cobetckoe/HeartbeatSensor/README.md

# 坎川工业 · 心跳探测器 v1.0.0



N4 模组（ESP32-C3-MINI-1-N4）+ HLK-LD2450 24GHz 毫米波雷达 + ST7735 彩屏的
实时目标跟踪与可视化固件，配 STC8G1K08A 从机做 433 MHz 单向下行，可选接入涂鸦云。

屏幕上是半圆雷达图：扫描量程圈、目标光点、方位网格、底部防区状态条。
左上角是 WiFi/云状态徽标，**右上角是电池电量徽标**。
开机先显示一块 **坎川工业** LOGO（齿轮 + 坎卦 ☵），然后直接进入雷达界面。

```
       ╭──────────────╮          量程 6 m / ±95°
      ╱   ●              ╲       最多同时 3 个目标
     │       ●            │      声呐波纹式 ping 圆环向外扩散
     │  ────────────      │      底部 4 防区状态条
      ╲                    ╱
       ╰──────────────────╯
        ▓▓▓▓  ▓▓▓▓  ░░░░  ░░░░
```

---

## 文档

| 文档 | 内容 |
|---|---|
| 本文 | 硬件、接线、构建烧录、按键语义、雷达规格 |
| [docs/HARDWARE.md](docs/HARDWARE.md) | 硬件说明：引脚约定、不可省略的硬件约束、从机充电方式 |
| [docs/PROTOCOL-433M.md](docs/PROTOCOL-433M.md) | 433 MHz OOK 空中协议（编码、帧结构、CRC、节奏） |
| [docs/DISPLAY.md](docs/DISPLAY.md) | 屏幕渲染：SPI 初始化、推帧门控、配色、版面几何、开机 LOGO |
| [docs/DIAGNOSTICS.md](docs/DIAGNOSTICS.md) | 诊断手册：现象速查表 + 串口日志逐条判读 + 两个必须知道的坑 |
| [docs/TUYA-DP-SETUP.md](docs/TUYA-DP-SETUP.md) | 涂鸦 DP 建点、倍数填写、三元组、数据中心 |
| [CHANGELOG.md](CHANGELOG.md) | 版本历史 |

---

## 硬件

**硬件设计（原理图 / PCB / 3D / BOM）在立创开源硬件平台发布，本仓库不含硬件工程文件。**

| 部件 | 型号 |
|---|---|
| 主控 | **N4 模组**（ESP32-C3-MINI-1-N4） |
| 雷达 | **HLK-LD2450** 24 GHz FMCW |
| 屏幕 | **ST7735** 1.8" 160×128 |
| 无线 | **433 MHz OOK** 发射 / 接收模组 |
| 从机 | **STC8G1K08A** SOP8 + **RCWL-0515** |
| 供电 | 主机 / 从机各用 3.7 V 锂电；从机由**弹匣式一拖四充电座**统一充电 |

- **主机与从机之间没有有线连接**，只有 433 MHz 单向无线链路（从机发射 → 主机接收）。
- **从机自身不带充电电路**，只引出 2 片磁吸触点，放回弹匣座即充。

> 引脚约定与不可省略的硬件约束见 [docs/HARDWARE.md](docs/HARDWARE.md)；
> 原理图、PCB、BOM 与装配细节见立创开源硬件平台项目页。

---

## 快速开始

### 1. 装依赖

```powershell
pip install -r requirements.txt   # pyserial
pip install Pillow                # 只有改 LOGO 才需要
```

### 2. 构建

```powershell
.\utils\build.ps1                 # 增量构建
.\utils\build.ps1 -Clean          # fullclean 后重建
.\utils\build.ps1 -Monitor        # 构建完进串口
```

### 3. 烧录

```powershell
.\utils\flash.ps1                 # 自动找串口 → 编译 → 烧录
.\utils\flash.ps1 -Port COM30 -Monitor   # 指定串口，烧完看输出
.\utils\flash.ps1 -Raw            # 绕过 pio，用 esptool 手动烧
```

板子认不出来时：**按住 BOOT 再点一下 RESET**，让它进下载模式。

> **为什么脚本要自己挑 pio**：本机有两个 pio，其中
> `C:\.platformio\penv\Scripts\pio.exe` 缺 `intelhex`，链接阶段会报
> `ModuleNotFoundError: No module named 'intelhex'`。两个脚本都会优先选不在
> `penv` 下的那个，不用手动处理。
>
> `-Raw` 走 esptool 手动写 4 个分区（bootloader / partitions / boot_app0 /
> firmware），实测可用，`pio upload` 抽风时拿它兜底。

### 4. 看日志

```powershell
python utils\serial_monitor.py    # 自动重连，已抑制 DTR/RTS 复位
```

**遇问题第一件事就是接串口。** 现象速查与日志判读全部见
[docs/DIAGNOSTICS.md](docs/DIAGNOSTICS.md)。

---

## 工程结构

```
HeartbeatSensor/
├── src/
│   ├── master/                       ★ 主机固件（N4 模组 / ESP32-C3，PlatformIO）
│   │   ├── master.ino                主程序：初始化 + 主循环
│   │   ├── HLK_LD2450.h              雷达协议解析（header-only）
│   │   ├── RadarDisplay.h            雷达界面渲染（header-only）
│   │   ├── OokReceiver.h             433M OOK 接收 + 解帧
│   │   ├── ZoneManager.h             防区管理 / 配对 / NVS 持久化
│   │   ├── DebugLog.h                零堆分配日志 + 复位原因
│   │   ├── BatteryMonitor.h          电池电压采样 + 电量百分比换算
│   │   ├── LogoImage.h               LOGO 点阵，脚本生成，勿手改
│   │   ├── TuyaLink.h                涂鸦云 MQTT + WiFi 状态机 + AP 配网
│   │   ├── TuyaConfig.h              涂鸦/配网参数集中配置
│   │   ├── QrTextImage.h             二维码说明文字点阵，脚本生成，勿手改
│   │   └── platformio.ini
│   └── slave/                        ★ 从机固件（STC8G1K08A，Keil C51）
│       ├── source/                   源码（GBK 无 BOM）
│       │   ├── main.c                主程序：初始化 + 主循环
│       │   ├── app.c                 按键 / 状态机 / 发送调度
│       │   ├── ook433.c              433 OOK 发射驱动
│       │   ├── board.h               引脚定义
│       │   └── include/              app.h / config.h / def.h / ook433.h / STC8 头文件
│       └── slave.uvproj              Keil 工程（BOM-free）
├── docs/                             ★ 细节文档
│   ├── PROTOCOL-433M.md              433 MHz OOK 空中协议
│   ├── DISPLAY.md                    屏幕渲染 + 开机 LOGO
│   ├── DIAGNOSTICS.md                诊断手册
│   ├── HARDWARE.md                   硬件说明：BOM / 接线 / 引脚 / 天线
│   └── TUYA-DP-SETUP.md              涂鸦 DP 建点
├── utils/                            构建 / 烧录 / LOGO / 串口脚本
│   ├── fonts/                        第三方字体（不入 Git，请跑 fetch_seal_font.py 下载）
│   └── *.png                        LOGO / 预览图（不入 Git，由 make_logo.py 生成）
├── CHANGELOG.md
├── LICENSE                           MIT 官方全文
├── NOTICE                            版权 / 第三方组件 / 致谢
└── requirements.txt
```

**在维护的固件只有两个**：主机 `src/master/`（PlatformIO）、从机 `src/slave/`（Keil C51）。

### 从机固件

需要 Keil C51 V9.60+：

```powershell
.\utils\build_slave.ps1          # 增量编译
.\utils\build_slave.ps1 -Clean   # 清理后完整重建
```

产出 `src\slave\Objects\slave.hex`，用 **STC-ISP** 烧录。

> ⚠️ `slave.uvproj` **不能带 UTF-8 BOM**，否则 UV4 静默失败（`Exit=15`，
> 不写日志、不报错、无产物）。`build_slave.ps1` 已自动检测并剥离。
> 同理，`src\slave\source\**` 的 `.c` / `.h` **必须保持 GBK 无 BOM**，
> Keil C51 按 GBK 解释源码，转成 UTF-8 会让中文注释炸成语法错误。

### PlatformIO 工程

`platformio.ini` 里用 `src_dir = .` 把 sketch 目录本身当源码根：

```powershell
pio run -d .\src\master              # 构建
pio run -d .\src\master -t upload    # 烧录
```

**不要同时跑两个 `pio run`**，会互相破坏 `.pio\build`。

---

## 工具脚本

| 脚本 | 用途 |
|---|---|
| `build.ps1` | 构建主机固件 |
| `flash.ps1` | 烧录主机固件 |
| `build_slave.ps1` | 构建从机固件（Keil UV4） |
| `make_logo.py` | 生成内置几何 LOGO |
| `logo_converter.py` | 把 PNG 转成固件点阵 |
| `fetch_seal_font.py` | 下载小篆字体 |
| `make_qr_text.py` | 二维码说明文字 → `QrTextImage.h` |
| `serial_monitor.py` | 简易串口监视 |

### LOGO

```powershell
python utils/make_logo.py                              # → utils/logo_*.png
python utils/logo_converter.py utils\logo_160x128.png  # → 固件点阵
```

**用自己的图**：存成 `utils/logo.png`（也认 `.jpg` / `.jpeg` / `.bmp`）再跑
`logo_converter.py` 即可。`make_logo.py` 永远不会覆盖 `logo.png`。

篆书版需先跑 `python utils/fetch_seal_font.py` 下 21.8 MB 字体（不入 Git）。
篆书在 160×128 的屏上认不出来，只用于大幅面 / 印刷，见
[`utils/fonts/README.md`](utils/fonts/README.md)。

`logo_converter.py` 两个产物：

- `src/master/LogoImage.h` —— 固件编译时自动 `#include`
- `utils/logo_preview.png` —— **屏上实际效果**，烧之前先看它

设计理念与全部输出版本见 [docs/DISPLAY.md](docs/DISPLAY.md) 第二部分。

### 二维码说明文字

配网页上那段说明文字是点阵图（GFX 字模没有中文）：

```powershell
python utils\make_qr_text.py     # → src/master/QrTextImage.h + qr_text_preview.png
```

改文案就改脚本里的字符串，跑完先看 `utils/qr_text_preview.png` 再构建。
`QrTextImage.h` 是**脚本生成**的，不要手改。

---

## 工作原理

上电流程：

```mermaid
flowchart TD
    A[上电] --> B[点亮背光]
    B --> C["硬件 SPI 初始化<br/>显式指定 SCLK/MOSI"]
    C --> D["initR BLACKTAB<br/>setRotation 1"]
    D --> E["显示 LOGO 1.5 s"]
    E --> F{"NVS 里<br/>有配置吗"}
    F -->|有| G[按存的参数开串口]
    F -->|没有| H[扫描 RX/TX 与波特率]
    G --> I{"收到合法数据吗"}
    I -->|是| K[进入雷达界面]
    I -->|否| H
    H --> J[锁定参数写入 NVS]
    J --> K
    K --> L["主循环 ~50 Hz"]
```

只识别一种数据帧头：`AA FF 03 00`，说明是雷达的目标跟踪帧。

雷达的**串口引脚和波特率只在第一次上电时扫描一次**，之后锁在 NVS 里，往后开机
直接按存的参数开串口，不再浪费时间扫描。想重新扫描：擦除 flash 重新上电。

主循环只做三件事：读帧 → 过滤 → 画。过滤条件是距离 0.05–8 m、角度 ±95°，
滤掉的是雷达偶发的 0 距离和越界噪声。

---

## 显示实现

屏幕子系统有一定陷阱（SPI 初始化顺序、离屏画布、脏矩形、推帧门控、配色分级、
角度约定），**完整说明见 [docs/DISPLAY.md](docs/DISPLAY.md)**。

三件必须知道的事：

- 必须在 `initR()` 之前调 `SPI.begin(TFT_SCLK, -1, TFT_MOSI, -1)`，任何地方都
  不要再调无参 `SPI.begin()`（会把 SCLK 从 GPIO6 挪到 GPIO4，直接花屏）
- 脏矩形起始列必须为偶数，否则 RISC-V 非对齐访存 panic
- SPI 时钟固定 20 MHz：40 MHz 会干扰 433 MHz 接收

---

## 按键

### 主机 BOOT

| 操作 | 效果 |
|---|---|
| 短按 BOOT | 开 / 关屏幕 |
| 双击 BOOT | 进入配对模式 |
| 长按 2 s | 开 / 关 WiFi（涂鸦云接入） |
| 长按 5 s | 恢复出厂（清防区 + 清 WiFi + 清三元组） |

配对模式内：单击切防区 A→B→C→D，长按 1.5 s 对当前防区开始配对。

### 从机 P3.2

按键语义**按状态分离**，而且**全部动作都在松手那一拍完成，没有任何等待窗口**：

| 状态 | 操作 | 效果 |
|---|---|---|
| **待机** | 单击（30~1200 ms） | 开检测 |
| **待机** | 长按 1.5~5 s | 进配对（20 s 窗口） |
| **检测** | 单击或长按 | 关检测（松手**立即**生效，不设时长上限） |
| **配对** | 单击或长按 | 退出配对，回待机 |

> 长按阈值 1.5 s 与主机 `BTN_LONG_PAIR_MS` 一致，现场两只手同时按住即可。
> 单击上限 1.2 s 与长按下限 1.5 s 之间留了 300 ms 空档，手抖不会误进配对；
> 超过 5 s 视为按钮被压住，整次丢弃。

**为什么不需要「等 400 ms 看有没有第二下」**：早期三个状态都「松手即刻切换」，
代价是待机态「单击开检测」与「双击进配对的第一下」无法区分。
现在把配对改成**长按**，单击与长按在时间上天然分开，所有状态都可以
松手即时生效——「关检测」永远是秒回的，「开检测」也不再有 0.4 s 延迟。

**布防态必须看到一次真实的按下采样才允许关闭检测。**
纯粹由 INT0 下降沿触发、从未采到过低电平的事件（例如 433 发射突发或
继电器吸合造成的地弹毛刺）在布防态会被拒绝——否则会出现「刚开好的检测
被自己关掉」，那是漏报。代价是：按下和松开正好都落在 146 ms 发射块里时，
这一次按压不生效，再按一下即可。详见
[docs/DIAGNOSTICS.md](docs/DIAGNOSTICS.md) 的「开了之后很快自己又关了」。

**从机上电默认待机**：不采样、继电器释放、只发 10 秒一次的「无人」心跳。
必须单击一次才真正开始检测。

> 为什么：RCWL-0515 和主板装在同一个壳里，上电后雷达会把**从机自己**
> 当成目标，OUT 直接拉高。原来「上电即检测」= 每台从机一上电就报有人，
> 主机所有防区同时亮红。改成上电待机后，装柜/调试期间从机是安静的，
> 装好、人离开、再按一下按钮才算真正布防。

**配对的两个退出路径**：20 s 超时自动回待机，或配对期间单击一下提前退出。
从机没有 RX（433 对从机是纯单向 TX），**感知不到主机「配对成功」**，
所以不存在「配对成功即自动退出」；看到主机提示配对完成后再单击一下即可。

**退出后短暂静音**（`s_click_mute`，400 ms）：在检测态快速连按两下时，
第二下不会被当成「待机单击」把检测又打开——连按两下的结果就是关闭。

开启检测后还有 `APP_ARM_BLIND_MS`（500 ms）的雷达基线盲区，
这是留给人员撤离的时间，属于有意设计，不要改小。

待机期的 10 秒慢心跳让防区在屏上/APP 上保持**在线**（主机离线门限 45 s）。
若现场待机时防区偶尔闪一下离线（433 链路丢帧是成簇的），
把 `app.h` 里的 `APP_STANDBY_HB_MS` 改小到 `5000u`。

### 从机按键指示灯（P3.2，纯硬件）

SOP8 的 8 个脚已经全部占满（P5.4 继电器 / P5.5 433 发射 / P3.0 P3.1 ISP /
P3.2 按键 / P3.3 雷达），**没有第二个可用的 IO**。所以按键指示灯不占用
任何新引脚，直接**串在 P3.2 的按键回路上**：

```
VCC ── LED ── R(330Ω~1k) ── P3.2 ──[按键]── GND
```

原理：P3.2 是准双向口，平时锁存器 = 1、内部弱上拉导通，引脚被拉到 VCC，
LED 两端等电位 → 无电流 → 灯灭。按下按键把引脚拉到 GND，电流经 LED + R
灌入地 → 灯亮；同时单片机读到低电平，按键逻辑照常工作。

**效果：手指按住按钮灯就亮，松开就灭 —— 固件完全不参与，没有任何延时。**

| 电阻 | 电流 | 观感 |
|---|---|---|
| 330 Ω | ≈4 mA | 够亮，准双向口上拉承受得住 |
| 1 kΩ | ≈1.3 mA | 偏暗但省电，室内仍可见 |

> 低于 220 Ω 会超出准双向口的驱动能力：灯反而变暗，甚至引脚电平抬不到
> 能识别的高电平，按键会读不到。

P5.4 因此**保持纯继电器输出**，不再兼任指示灯，也不会再因为「提示闪烁」
把继电器带得咔哒响。

---

## 涂鸦云接入（可选功能）

默认关闭，离线优先。长按 BOOT 2 秒开 WiFi，再长按 2 秒关。

### 配网

1. 长按 BOOT 2 秒，设备开热点 `Kanchuan-HB-XXXX`（开放，无密码）
2. 手机连该热点，浏览器自动弹出配网页（或手动开 `192.168.4.1`）
3. 选路由、填密码，需要换设备时展开「涂鸦云三元组」填 DeviceID / DeviceSecret
4. 保存后设备自动重启并直连

三元组也可写死在 `TuyaConfig.h`（`TUYA_PRODUCT_ID` / `TUYA_DEVICE_ID` /
`TUYA_DEVICE_SECRET`），NVS 优先于宏。数据中心选「中国数据中心」，选错设备不上线。

### DP 与绑定

**7 个 DP**（4 个 bool + 3 个数值），全部只上报。DP 清单、建点步骤、倍数填写、
三元组与数据中心设置见 **[docs/TUYA-DP-SETUP.md](docs/TUYA-DP-SETUP.md)**。

> ⚠️ 数值型 DP 的「倍数」必须填 **`0`**。填 `1` 会被平台当成一位小数，
> APP 上数字小 10 倍。

> ⚠️ **平台上只建这 7 个点。** 早期固件多报了 4 个 `zone_*_online`，
> 而平台上根本没建这四个点 → 涂鸦云**静默丢弃**（`publish()` 仍返回成功，
> 日志一切正常，但云端永远收不到）。防区离线状态现在不再单独上报，
> 现场以屏幕底部的三态防区条为准。

涂鸦智能 App **扫码添加不适用**——本固件直连云 MQTT，不走 App 配网，
不产生绑定 token。要进 App 需走云开发 OpenAPI 绑定或自研 App。

---

## 雷达规格

| 项目 | 参数 |
|---|---|
| 探测距离 | 0–6 m（本工程） |
| 角度范围 | ±60°（本工程过滤到 ±95°） |
| 最大目标 | 3 个 |
| 协议 | UART，头部 `AA FF 03 00` |
| 刷新率 | ~10 Hz（模组侧） |
| 屏幕量程标注 | 圈上标 `2m` / `4m` / `6m` |

### 航迹跟踪（为什么显示是稳的）

传感器本身只有 3 个目标槽位，而且会随时重排。直接照抄它的输出会看到三种
「不准」，本工程在画之前加了一层航迹跟踪来消除：

| 现象 | 原因 | 处理 |
|---|---|---|
| 同一个人莫名其妙换颜色 | 颜色按传感器槽位取，槽位会重排 | 持久航迹池 + 最近邻关联，目标自己占住一个槽 |
| 光点持续小幅抖动 | 传感器 10 Hz、屏幕 50 Hz，同一采样重复画 5 帧 | EMA 平滑（系数 0.45） |
| 目标偶尔闪一下消失 | 传感器漏采一次（该槽 x=y=0） | 350 ms 短时保持 |
| 角度偏一点 | 原按 2° 栅格对齐后查表 | 2° 查表 + 线性插值，量化误差 ~0.02° |

精确数值以云端 DP 为准（`radar_distance` 1 cm / `radar_angle` 1°），
屏幕上只标量程圈 `2m` / `4m` / `6m` 和方位角刻度 `-60 / -30 / 30 / 60`，
不占额外版面。

---

## 改文档的规矩

1. **一个事实只写一处**，其他地方链接过去。同一参数在两个文档里写两个值，
   迟早会有一个是错的。
2. 所有 `.md` 存 **UTF-8 带 BOM**。PowerShell 5.1 的 `Out-File -Encoding UTF8`
   会带 BOM，但 `Set-Content` 不一定，写脚本时用
   `[System.IO.File]::WriteAllText($p, $s, (New-Object System.Text.UTF8Encoding($true)))`。
3. `src/slave/source/**` 的 `.c` / `.h` 必须保持 **GBK 无 BOM**（见上文）。
4. 贴代码时贴**真实格式串**，不要手打近似值——日志格式改了要同步改文档。

---

## 开源协议

[MIT License](LICENSE)

Copyright (C) 2026 Kanchuan Industrial。
第三方组件、派生作品与致谢的声明见 [NOTICE](NOTICE)。

## 致谢

- **Adafruit** — GFX / ST7735 驱动
- **eric-rolph/esp32-radar-tracker** — ESP32-S3 + HLK-LD2450 雷达跟踪器参考项目（Arduino / CircuitPython 双实现）：
  <https://github.com/eric-rolph/esp32-radar-tracker>
