cobetckoe/HeartbeatSensor/docs/SERIAL-LOG.md

# 串口日志与判读

115200 baud，**事件驱动**（不轮询、不刷屏）。正常静默运行，只有下面这些
时机才会有输出。日志全部走 `DebugLog.h` 的 `dbgLog()`：224 字节栈缓冲、
零堆分配、USB CDC 非阻塞发送（缓冲区满直接丢，绝不阻塞主循环）。

**排查任何问题的第一步都是接串口。** 本文按日志行分组，每条都给出真实格式串
（从 `src/master/master.ino` 直接复制）和判读方法。

---

## 1. 开机

```
=== HEARTBEAT v7 C3 ===
[BOOT] reset=%s raw=0x%02X(%s) heap=%lu
[ZONE] stored=%d
[ZONE]  #%d id=%s name=%s en=%d
[BOOT] loop WDT %s (5s)
[OK] %s
```

真实示例：

```
=== HEARTBEAT v7 C3 ===
[BOOT] reset=SW raw=0x03(SW) heap=265004
[ZONE] stored=1
[ZONE]  #0 id=F7:94:C6:19:19:CB:3D name=A en=1
[BOOT] loop WDT armed (5s)
[OK] RUNNING
```

### `[BOOT] reset=` —— 第一行就该看这个

现场说「死机了」之后重启，靠这一条就能把原因分到三类，**三者修法完全不同**：

| `reset=` | 含义 | 该查什么 |
|---|---|---|
| `SW` / `0x03` | 软件复位（`ESP.restart()`） | 正常：配网保存后、工厂复位后都会这样 |
| `BROWNOUT` / `0x0F` | **掉电复位** | 供电被拉垮。最常见：433 发射瞬间 Vcc 塌陷、USB 线太细、雷达 5V 与模块共用一路 |
| `TASK_WDT` / `0x0B` | **主看门狗** | 主循环被阻塞 5s 以上。查是否有新增的阻塞调用 |
| `PANIC` | 程序异常 | 看核心转储；常见是 `LoadStoreAlignment`（非对齐访存）或踩穿栈 |
| `0x15` | USB 串口（烧录后） | 正常：刚烧完就这行 |

### `[ZONE] stored=` —— 配不上对时的决定性证据

打印主机 EEPROM 里**已保存的**从机 ID。必须拿它和后面 `[OOK]` 行里从机
**实际发的** ID 逐字节对照：

- 一致 → 配对正常
- **不一致 → 主机根本不认这台从机**。换芯片 / 换整块板子后 STC8 的出厂
  唯一 ID 就变了，此时「防区永远离线、报警反复复位」，现场表现像「采样慢 /
  延时大 / 从机重启」，实际是没配对
- `stored=0` + `(empty - press PAIR on the slave)` → 从没配过对

> ⚠️ **只看到 `[OOK]` 行就以为收到了，是最容易踩的坑。** `[OOK]` 行是无条件
> 打印的（任何 ID 都打），而只有 ID 匹配才会更新防区。

### `[OK] RUNNING` / `[OK] NO DATA`

雷达 UART 是否在开机时探测到数据。`NO DATA` 不代表故障——本固件会把 UART
先起在 256000，之后传感器上电/复位还能接住，屏幕依然进雷达界面。
真正的判据是下面第 3 节的 `[RADAR]` 行。

---

## 2. 收帧事件

```
[OOK] %02X:...:%02X flags=%02X seq=%u
[OOK] Already-known device seen during pairing
```

`[OOK]` 只在**首次见到某台设备**时打印（靠 `static s_logId[7]` 去重），
不是每帧都刷。所以日志里有这一行 = 射频链路和协议解码都是通的。

`flags` 位含义：

| 位 | 含义 |
|---|---|
| `0x01` | `OOK_FLAG_PRESENCE` 检测到人 |
| `0x08` | `OOK_FLAG_PAIRREQ` 从机主动请求配对 |
| `0x80` | `OOK_FLAG_BOOT` 从机刚重启（开机后前几帧置位，正常运行永不置位） |

`0x02` / `0x04` 是协议保留位（防拆 / 低电），从机目前从不置位。

---

## 3. 每分钟健康日志（核心）

每 60 秒打印一组 7 行。**这是验证长期可靠性的唯一客观手段。**

```
[ZONE ] zn=%d act=%d
[ZONE ]  #%d id=%s name=%s en=%d on=%d f=%u age=%lums     ← 每个防区一行
[HEALTH] up=%lum heap=%lu min=%lu loop=%lums stk=%u tstk=%u ook=%lu crc=%lu nz=%lu ovf=%lu T=%uus rst=%u rbt=%lds wdt=%s did=%s
[GATE] fs=%lu fh=%lu
[RADAR] ok=%lu bad=%lu raw=%lu
[FAIL] f1=%u f2=%u f3=%u f4=%u f5=%u f6=%u f7=%u f8=%u f10=%u f11=%u
[FIXB] fixed=%lu wbit=%d wcnt=%u
```

### `[HEALTH]` —— 现场只需先看这三个数

| 字段 | 含义 | 正常值 |
|---|---|---|
| `heap` | 当前空闲堆 | ≥ 180000，且**不单调下跌** |
| `min` | 上电以来最低水位 | **等于 `heap` ⇒ 零泄漏**（稳态下两者应几乎相同） |
| `loop` | 主循环最坏耗时（本分钟） | 10–20 ms，必须远小于 5000（WDT） |
| `up` | 连续运行分钟数 | 递增；**变小说明重启过** |

其余字段：

| 字段 | 含义 | 判读 |
|---|---|---|
| `stk` | 主循环栈剩余（字节） | > 1500 安全；**< 500 立即加大** |
| `tstk` | tuya 任务栈剩余 | > 3000 安全；**< 500 改 `TUYA_TASK_STACK`** |
| `ook` | 累计有效帧 | 单调递增 |
| `crc` | 累计校验错 | 应长期接近 0（1% 以内属信道正常噪声） |
| `nz` | 噪声突发数 | **大而 `ook` 小** → 433 接收模块一直在自激，帧头立不起来，是射频问题，调固件无用；**小** → 接收机干净，问题在信号弱（功率/天线/距离）或从机发得不对 |
| `ovf` | RMT 环形缓冲溢出次数 | > 0 说明主机边沿都来不及读，**帧是主机丢的，与射频无关** |
| `T` | 单位时长估计（µs） | 设计值 350。明显偏离说明接收模块脉宽失真 |
| `rst` | 从机重启次数 | 见下表 |
| `rbt` | 距上次重启秒数 | `-1` = 从未观察到重启 |
| `wdt` | 看门狗状态 | 必须是 `armed`；`FAILED` 才是真故障 |
| `did` | 涂鸦 DeviceID | 未配网时为空 |

**`rst` / `rbt` 判读：**

| 现象 | 结论 |
|---|---|
| `rst` 不涨，`rbt` 很大或 `-1` | 从机运行正常，问题在射频 / 供电 |
| `rst` 持续上涨，`rbt` 很小 | **从机在反复重启**。最常见：433 发射瞬间把 Vcc 拉塌导致欠压复位 |
| `rst` 涨一次就停 | 只是上电启动，正常 |

> `rst` 用 `OOK_FLAG_BOOT` 做确定性判据，**不靠 seq 猜**。因为 seq 只有 8 位，
> 从机约 35~40 帧/分，6~7 分钟就回绕一次，「seq 变小」既可能是重启也可能是
> 回绕。判定窗口取 5s 会漏检（丢帧 85% 时相邻帧间隔常 > 5s），取 60s 又会把
> 正常回绕误报成重启——两个方案都实测被证伪过。

### `[ZONE ]` 行

| 字段 | 含义 |
|---|---|
| `zn` / `act` | 已配防区数 / 当前活动槽位 |
| `on` | 是否在线 |
| `f` | **该防区最近 60 秒收到多少有效帧** |
| `age` | 当前帧龄（距最近一帧成功解码多久） |

`f` 是「多防区链路质量」的唯一硬指标。**心跳已从 3000 ms 改成 2000 ms，
判读基准必须跟着改**，否则现场会把正常误判成丢帧：

| `f` | 结论 |
|---|---|
| 45~60 | 链路正常（设计值 2000 ms/次 × 2 帧 = 60 帧/分） |
| 15~30 | 丢帧明显（天线 / 距离 / 供电 / 相位碰撞） |
| 0 | 该防区链路已断（或从未配对），看 `nz` / `age` 区分是射频问题还是 ID 不匹配 |

四个防区的 `f` **相差很大** = 典型的相位碰撞或某台天线差；
**四个都低** = 主机侧问题（接收模块 / 干扰 / 推屏门控）。

> ⚠️ **防区槽位必须逐个打印。** 这是踩过的真实误判：实际数据在 3 号槽
> （0/1/2 是空槽），而诊断只取了 `zoneAgeMs(0)` —— 空槽 `lastSeenMs` 恒为 0，
> 于是 `age` 天生等于开机时长，看起来像「从来没配对成功」，据此得出的
> 「ID 不匹配」结论完全是假的。多槽结构一律全打印，不要假设 0 号槽。

### `[GATE]` —— 联网后才需要看

`fs` = 软强制放行次数，`fh` = 硬强制放行次数（本分钟）。

| 数值 | 含义 |
|---|---|
| `fs=0 fh=0` | 门控从来没卡住过（WiFi 关或干扰很轻），画面一直流畅 |
| `fs` 有小量、`fh=0` | 只是安静窗偶尔不满足，柔性强制已够，正常 |
| **`fh` 持续增长** | 433 接收模块被 2.4 GHz 压得**持续自激**——屏幕靠硬强制保活，属射频/摆位问题（挪远天线、加电源去耦），调固件无用 |

机制说明见 [DISPLAY.md](DISPLAY.md) 第 3 节「分级强制放行」。

### `[RADAR]` —— 「雷达不出数」的第一个分叉点

| 字段 | 含义 |
|---|---|
| `raw` | UART1 累计收到的**字节数** |
| `ok` | 校验通过并解析成功的完整帧数 |
| `bad` | 帧头对上但帧尾不对的帧数 |

| 现象 | 结论 |
|---|---|
| `raw` 一直不涨 | **物理层没通**：TX/RX 接反、传感器没供电、传感器还在启动（LD2450 上电约 1 s） |
| `raw` 在涨、`ok` 不涨 | 波特率不对（本工程按 256000 探测）或帧被截断 |
| `bad` 明显增长 | 线路噪声，或波特率擦边（帧头对上、帧尾不对） |
| `ok` 在涨但屏幕上没点 | **已进入算法层**：看防区 / 跟踪门限，与 UART 无关 |

### `[FAIL]` —— 丢帧到底丢在哪道闸门

解码器每道闸门失败时用 `_fail(code)` 记一次，每分钟打一张直方图。
**一次 60 秒就能给出确定答案，不必再猜：**

| 占比最高 | 根因 | 对策 |
|---|---|---|
| **F11** | 位判错了（段长都在合法窗口内，只是长短判反）。根因是接收机 AGC 在某几个位上把边沿拉偏 ~250 µs | 调 `OOK_BIT_MIN/MAX` **无用**（本来就没越界）。看 `[FIXB]` |
| F2 / F3 / F7 / F8 | 有段长越界 → 这才是窗口问题 | 扩 `OOK_BIT_MIN` / `OOK_BIT_MAX` |
| F5 | 两簇分不开 → 该帧形状整体坏 | 通常是干扰 / 推屏致盲 |
| F1 / F6 | 载荷段数不够 → 帧尾被帧间隔吞掉的比例变了 | 查帧间隙 / 从机发送节奏 |
| F4 | 有效样本太少 → 帧体大面积丢失 | 查射频 |
| F10 | 出现等长段 → 极可能是噪声凑出来的假帧 | 查 `nz` |

### `[FIXB]` —— 单比特纠错成效

| 字段 | 含义 |
|---|---|
| `fixed` | 靠单比特纠错救回的帧数（说明纠错真在起作用，通信可靠性已实质提升） |
| `wbit` | 出错最集中的比特位 |
| `wcnt` | 该位出错的次数 |

若 `wbit` **长期固定在某一位**（尤其 79 号末位），说明该位的判定方法有
系统偏差（末位缺少配对段，只能靠全帧中点门限），应针对该位单独优化，
而不要整体调门限。

---

## 4. 事件类日志（低频，始终保留）

配对、工厂复位、按键等事件随时打印，不占用 60 秒节拍。

---

## 5. 两个必须知道的坑

**串口日志里不会出现任何 `[E]` 行。** `platformio.ini` 的
`-DCORE_DEBUG_LEVEL=0` 使 Arduino HAL 的 `log_e` / `log_w` / `log_i`
全部编译为空语句，所以像 `spiAttachMISO()` 那类无害但看着像故障的提示不会出现。
**若日志里真的冒出 `[E]`，那就是真故障，可以直接当报警看。**

**ESP32-C3 用原生 USB，打开串口这个动作本身会让芯片复位**（DTR/RTS）。
想测真实连续运行时间，请用 `utils/serial_monitor.py`（已做 DTR/RTS 抑制
+ 自动重连），不要用串口助手直接点开。
