cobetckoe/HeartbeatSensor/CHANGELOG.md

# 版本历史

## [未发布]

### 许可

- 开源协议由 **GPL-3.0-only** 回退为 **MIT**，采用最简单的单一许可结构。
  MIT 允许将 MIT 派生作品并入本工程，无需维护混合许可声明。
- `LICENSE` 改为 **MIT 官方全文**（不加任何附加段落），
  GitHub 可自动识别为 MIT。
- `NOTICE` 重写为 MIT 归属结构：项目版权抬头 → 派生作品
  （eric-rolph/esp32-radar-tracker，保留原 MIT 许可与版权全文）→ 第三方组件
  （Adafruit MIT/BSD、海凌科 HLK-LD2450、Keil C51 工具链）→ 致谢 → 联系方式。
- 全部源码的 SPDX 标识由 `GPL-3.0-only` 改回 `MIT`
  （主控 11 个文件 + 从机 7 个文件 + 2 个自动生成头文件）。
- 自动生成脚本 `utils/logo_converter.py`、`utils/make_qr_text.py` 同步改回 MIT。
- README 顶部 badge 改为 MIT，末章「开源协议」改为 MIT 链接与版权行。

### 命名

- 中文名称统一为 **心跳探测器**（原「毫米波雷达跟踪器」）。
  涉及 README 标题、`docs/HARDWARE.md` 标题、`src/master/master.ino` 文件头、
  `utils/build.ps1` / `utils/flash.ps1` 脚本说明。
  英文仓库名与目录名保持 `HeartbeatSensor` 不变。
  上游参考项目 `eric-rolph/esp32-radar-tracker` 的引用文字不改。

### 硬件

- **硬件设计（原理图 / PCB / 3D / BOM）改在立创开源硬件平台发布**，
  本仓库不含任何硬件工程文件。
- `docs/HARDWARE.md` 精简为「只提及」：从 15 245 字节降到 5 862 字节，
  只保留**固件强耦合的引脚约定**与**不可省略的硬件约束**两张表，
  其余（接线总表、物料清单、装配自检、充电座结构）全部指向立创项目页。
- 从机充电方式说明（只提及，不展开）：
  - **从机自身不带充电电路**，只引出 **2 片磁吸触点**，电池正极串 PTC 0.75 A。
  - **充电座即弹匣本体，一拖四**，插进去即充；磁极防呆，反了吸不住。

### 文档

- README 硬件章节改为**只提及**：删除接线总表、电池分压电路、从机接线、
  strapping 说明、引脚占用表、装配自检速查表、「供电与充电」小节，
  只留 6 行器件表 + 两句要点 + 指向立创项目页与
  `docs/HARDWARE.md` 的链接。
- README 由 477 行精简到 **444 行**。

### 致谢

- 收录参考项目 **eric-rolph/esp32-radar-tracker**（MIT）：
  <https://github.com/eric-rolph/esp32-radar-tracker>
- README「致谢」与 `NOTICE`「Acknowledgments」同步加入该项目。
- `src/master/HLK_LD2450.h` 基于该项目 `arduino/HLK_LD2450.h` 修改而来，
  `NOTICE` 中增加其 MIT 许可与版权声明，文件头保留原始归属。

## [1.0.0] - 2026-11-04

首次发布。

### 新增：电池电压监测与电量徽标

- `src/master/BatteryMonitor.h`（新增）：GPIO0 / ADC1_CH0，12 dB 衰减，
  `analogReadMilliVolts()` 走 eFuse 出厂校准，10 s 采样一次，13 点放电曲线查表换百分比
- 硬件：VBAT 经 1MΩ/1MΩ 分压，**中点必须并 100 nF**（源阻抗 500 kΩ，
  否则 SAR ADC 读数偏低）；分压常驻耗电 2.1 µA，约 1.8 %/yr
- 屏幕右上角电量徽标：外壳 17×9 @ (138,2)，正极尾巴 2×4，擦除区 (137,1)-(157,11)
  - ≥50% 绿 / 20~49% 琥珀 / <20% 红 / <5% 红且 1 Hz 闪烁
  - 未知（未采到电压）时**整块不画**，不误报 0%
- 电压越界（<1.5 V 或 >4.5 V）按 0% 显示，便于现场一眼识别接线错误

### 修复：涂鸦 DP 收敛为 7 个

- **删掉 4 个 `zone_*_online` DP**。平台上根本没建这四个点 → 涂鸦云**静默丢弃**
  （`publish()` 仍返回成功，日志一切正常，但云端永远收不到）—— 最难查的失败模式。
- 现在只上报平台上真实存在的 7 个点：101 距离 / 102 角度 / 103 目标数 /
  104~107 四个防区 presence
- MQTT 缓冲 1024 → 512 字节（7 个 DP 完整上报约 350 B）
- 防区离线状态不再单独上报，现场以屏幕底部三态防区条为准

### 修复：从机上电自动开检测（P3.2 浮空毛刺）

- `App_Init()` 在 `EA = 1` **之前**补 `IE0 = 0`。
  8051 的 `TCON.IE0` 是硬件边沿锁存，**与 `EX0` 无关** —— 上电爬升期间
  P3.2 上的任何下降沿都会被锁存，`EA` 一开就立刻进 ISR，
  待机态的边沿补救路径把浮空/毛刺当成一次按压 → 直接自动开检测。
- 电气结论：准双向口 P3.2 在 latch=1 时约 30 kΩ 内部弱上拉，
  悬空读数是稳定高电平（未按下），不存在阈值抖动 —— **IE0 锁存是唯一真实风险**。

### 文档

- `docs/TUYA-DP-SETUP.md` — 重写为 7 个 DP，补充 scale 语义、step=2 说明、
  以及「平台未建点会被静默丢弃」的来龙去脉
- `docs/DISPLAY.md` — 新增「顶部徽标区」章节：电池徽标几何、颜色分档、数据来源
- `README.md` — 引脚表、strapping 策略、电池接法、7 个 DP

### 资源占用

| 项目 | 数值 |
|---|---|
| 主机 RAM | 14.6 %（47820 / 327680 B） |
| 主机 Flash | 78.8 %（1032480 / 1310720 B） |
| 从机 `data` | 11.0 B |
| 从机 `xdata` | 58 B |
| 从机 `code` | 2479 B |
| 从机 hex | 7415 B（上限 8185 B，余量约 770 B） |
| 从机编译 | 0 Error / 0 Warning |

### 系统构成

- **主机**：N4 模组（ESP32-C3-MINI-1-N4）+ HLK-LD2450 24 GHz 毫米波雷达 + ST7735 1.8" 160×128 彩屏
- **从机**：STC8G1K08A SOP8 + RCWL-0515 微波感应 + 433 MHz OOK 发射模组
- **链路**：433 MHz OOK 单向下行（从机 → 主机），1 主机对最多 4 从机（防区 A/B/C/D）
- **云**：涂鸦云 MQTT 可选接入，默认关闭、离线优先

### 雷达与显示

- 半圆雷达界面：量程 6 m，方位 ±95°，最多同时跟踪 3 个目标
- 声呐波纹式 ping 圆环、2/4/6 m 量程圈、方位网格、底部 4 防区状态条
- 硬件 SPI 20 MHz（40 MHz 会干扰 433 MHz 接收）、`GFXcanvas16` 离屏合成、脏矩形增量推送
- 三级强制放行门控：正常等待 → 120 ms 软强制（1200 px）→ 400 ms 硬强制（600 px，帧内也强制），
  推屏预算自适应负反馈（正常 +20/帧、硬强制 −300，钳在 1500~3000）
- 背景静态部分开机预烘焙，每帧 `memcpy` 复用
- 开机显示坎川工业 LOGO 1.5 s（齿轮 + 坎卦 ☵，亮金 `#FFD800` + 正红 `#E60012`）

### 航迹跟踪

- 持久航迹池 + 最近邻关联，解决传感器槽位重排导致的目标换色
- EMA 平滑（系数 0.45）消除 10 Hz 传感器与 50 Hz 屏幕之间的重复帧抖动
- 350 ms 短时保持，遮盖传感器单次漏采
- 2° 查表 + 线性插值，量化误差约 0.02°

### 433 MHz OOK 协议

- PT2262 / EV1527 脉宽编码，`T = 350 µs`，码率 714 bps，与 rc-switch protocol 1 兼容
- 前导码 20 个 2T 脉冲 + 同步头（1T 高 / 16T 低）+ 10 字节载荷（ID7 / FLAGS1 / SEQ1 / CRC1）
- CRC-8/ATM（多项式 `0x07`，初值 `0x00`，无反射，无异或输出）
- 帧空中时间 145.95 ms（417T），协议 202 段、主机可捕获 201 段
- 主机侧 RMT 硬件解码（1 MHz tick），CPU 零参与；12 ms 空闲判帧
- 从机侧 `OOK_SendFrame()` 关中断阻塞发射，INT0 硬件仍锁存 `IE0`，`EA` 恢复后补处理

### 从机行为

- **上电默认待机**：不采样、继电器释放，避免上电时雷达把从机自身当目标导致全防区误报
- 待机期 10 s 慢心跳（2 帧），维持主机侧 45 s 离线门限内的「在线 + 无人」
- 状态变化立即发 3 帧；布防态心跳 2 s 一次
- 发送抖动 `gap_ms = 20 + (ID[0] % 40)`，多从机自然错开；最坏响应延迟约 556 ms
- 按键语义按状态分离，**全部动作在松手那一拍完成**：
  待机单击（30~1200 ms）开检测、待机长按（1.5~5 s）进配对、
  检测态单击或长按关检测、配对态单击或长按退出配对
- 布防态必须采到一次真实按下电平才允许关闭检测，拒绝 433 发射突发 / 地弹毛刺造成的假边沿
- 配对 20 s 窗口，两条退出路径（超时 / 按键），退出后 `s_click_mute` 400 ms 静音
- 从机无接收通路，无法感知「配对成功」，故不存在配对成功自动退出
- 按键指示灯纯硬件串在 P3.2 回路，零 IO 占用、零固件参与

### 主机按键

- 短按 BOOT 开关屏幕，双击进配对，长按 2 s 开关 WiFi，长按 5 s 恢复出厂

### 诊断

- `dbgLog()`：224 字节栈缓冲、零堆分配、USB CDC 非阻塞，115200 baud 事件驱动
- 每分钟健康日志：`[HEALTH]` / `[ZONE ]` / `[GATE]` / `[RADAR]` / `[FAIL]` / `[FIXB]`
- 复位原因与从机重启标记（`BOOT` 标志位）写入日志，仅用于诊断不参与报警判断
- 编译期 `-DCORE_DEBUG_LEVEL=0` 压制 Arduino HAL 的 SPI MISO 提示，成品日志无 `[E]` 行

### 工具链

- `utils/build.ps1` / `utils/flash.ps1`：主机固件构建与烧录，自动避开缺 `intelhex` 的 pio
- `utils/build_slave.ps1`：从机 Keil UV4 构建，自动剥离 `slave.uvproj` 的 UTF-8 BOM
- `utils/make_logo.py` / `logo_converter.py` / `fetch_seal_font.py`：LOGO 生成与点阵转换
- `utils/make_qr_text.py`：配网页说明文字点阵生成
- `utils/serial_monitor.py`：抑制 DTR/RTS 复位的简易串口监视

### 文档

- `README.md` — 硬件、接线、构建烧录、按键语义、雷达规格
- `docs/PROTOCOL-433M.md` — OOK 空中协议
- `docs/DISPLAY.md` — 屏幕渲染与开机 LOGO
- `docs/DIAGNOSTICS.md` — 现象速查 + 日志判读
- `docs/TUYA-DP-SETUP.md` — 涂鸦 DP 建点
