cobetckoe/HeartbeatSensor/src/slave/source/main.c

//<<AICUBE_USER_HEADER_REMARK_BEGIN>>
////////////////////////////////////////
// 文件名称: main.c
// 文件描述: 从机主程序 - STC8G1K08A + 433M OOK 发射
////////////////////////////////////////
// Copyright (C) 2026 Kanchuan Industrial
// SPDX-License-Identifier: MIT
//<<AICUBE_USER_HEADER_REMARK_END>>


#include "config.h"                     //默认已包含stdio.h、intrins.h等头文件


//<<AICUBE_USER_INCLUDE_BEGIN>>
// 在此添加用户头文件包含  
#include "board.h"
#include "ook433.h"
#include "app.h"
//<<AICUBE_USER_INCLUDE_END>>


//<<AICUBE_USER_GLOBAL_DEFINE_BEGIN>>
// 在此添加用户全局变量定义、用户宏定义以及函数声明  
//<<AICUBE_USER_GLOBAL_DEFINE_END>>




////////////////////////////////////////
// 项目主函数
// 入口参数: 无
// 函数返回: 无
////////////////////////////////////////
void main(void)
{
    //<<AICUBE_USER_MAIN_INITIAL_BEGIN>>
    // 在此添加用户主函数初始化代码  
    //<<AICUBE_USER_MAIN_INITIAL_END>>

    SYS_Init();

    //<<AICUBE_USER_MAIN_CODE_BEGIN>>
    // 在此添加主函数中运行一次的用户代码  
    App_Init();
    //<<AICUBE_USER_MAIN_CODE_END>>

    while (1)
    {
        //<<AICUBE_USER_MAIN_LOOP_BEGIN>>
        // 在此添加主函数中用户主循环代码  
        App_Run();
        //<<AICUBE_USER_MAIN_LOOP_END>>
    }
}

////////////////////////////////////////
// 系统初始化函数
// 入口参数: 无
// 函数返回: 无
////////////////////////////////////////
void SYS_Init(void)
{
    EnableAccessXFR();                  //使能访问扩展XFR
    IAP_SetTimeBase();                  //设置IAP等待参数,产生1us时基

    //<<AICUBE_USER_PREINITIAL_CODE_BEGIN>>
    // 在此添加用户预初始化代码  
    //<<AICUBE_USER_PREINITIAL_CODE_END>>


    //<<AICUBE_USER_INITIAL_CODE_BEGIN>>
    // 在此添加用户初始化代码  
    //<<AICUBE_USER_INITIAL_CODE_END>>
}

////////////////////////////////////////
// 微秒延时函数
// 入口参数: us (设置延时的微秒值)
// 函数返回: 无
////////////////////////////////////////
void delay_us(uint16_t us)
{
    do
    {
        NOP(14);                        //(MAIN_Fosc + 500000) / 1000000 - 10
    } while (--us);
}


////////////////////////////////////////
// 毫秒延时函数
// 入口参数: ms (设置延时的毫秒值)
// 函数返回: 无
////////////////////////////////////////
void delay_ms(uint16_t ms)
{
    uint16_t i;

    do
    {
        i = MAIN_Fosc / 10000;
        while (--i);
    } while (--ms);
}



//<<AICUBE_USER_FUNCTION_IMPLEMENT_BEGIN>>
// 在此添加用户函数实现代码  
//<<AICUBE_USER_FUNCTION_IMPLEMENT_END>>
