cobetckoe/HeartbeatSensor/src/master/QrTextImage.h

// QrTextImage.h - 由 utils/make_qr_text.py 自动生成，请勿手工编辑
// 中文提示点阵（1bit 掩膜，颜色在绘制时指定）
//
// Copyright (C) 2026 Kanchuan Industrial
// SPDX-License-Identifier: MIT
#ifndef QR_TEXT_IMAGE_H
#define QR_TEXT_IMAGE_H

#include <Arduino.h>

// HINT1  系统相机  48x12
#define QRT_HINT1_W 48
#define QRT_HINT1_H 12
static const uint8_t QRT_HINT1[72] = {
  0x00, 0xC0, 0x10, 0x10, 0x00, 0x00, 0x3F, 0x02, 0x10, 0x13, 0xE2, 0x38, 0x04, 0x02, 0x7E, 0x32,
  0x23, 0x2C, 0x19, 0x85, 0x90, 0x7E, 0x27, 0xA4, 0x1E, 0x07, 0x24, 0x33, 0xE2, 0x2C, 0x0C, 0xC2,
  0x66, 0x32, 0x23, 0x2C, 0x3B, 0xE2, 0x7A, 0x3E, 0x27, 0xAC, 0x02, 0x27, 0x28, 0x73, 0xE6, 0x2C,
  0x12, 0x80, 0x28, 0x52, 0x22, 0x6C, 0x22, 0x63, 0xA8, 0x12, 0x22, 0x48, 0x46, 0x24, 0x4E, 0x13,
  0xE2, 0xC6, 0x04, 0x00, 0x04, 0x00, 0x00, 0x00,
};

// HINT2  扫码入网  48x11
#define QRT_HINT2_W 48
#define QRT_HINT2_H 11
static const uint8_t QRT_HINT2[66] = {
  0x10, 0x00, 0x20, 0x08, 0x03, 0xFC, 0x13, 0xE7, 0x84, 0x0C, 0x04, 0x06, 0x78, 0x22, 0x04, 0x04,
  0x04, 0x02, 0x10, 0x22, 0x24, 0x06, 0x06, 0x6A, 0x11, 0x23, 0xA4, 0x06, 0x05, 0xB2, 0x18, 0x26,
  0xBE, 0x0D, 0x04, 0x92, 0x70, 0x26, 0x82, 0x09, 0x05, 0x92, 0x10, 0x22, 0xBE, 0x10, 0x85, 0x6A,
  0x10, 0x23, 0x82, 0x30, 0xC6, 0x62, 0x13, 0xE2, 0x02, 0x60, 0x64, 0x06, 0x20, 0x20, 0x04, 0x00,
  0x04, 0x04,
};

// HINT3  勿用微信  48x11
#define QRT_HINT3_W 48
#define QRT_HINT3_H 11
static const uint8_t QRT_HINT3[66] = {
  0x10, 0x01, 0xFC, 0x24, 0x81, 0x10, 0x10, 0x03, 0x22, 0x64, 0x83, 0x10, 0x3F, 0xE2, 0x22, 0x5E,
  0xE2, 0x00, 0x25, 0x23, 0xFE, 0x2F, 0xA6, 0x44, 0x49, 0x22, 0x22, 0x61, 0x06, 0x00, 0x09, 0x23,
  0x22, 0x61, 0x82, 0x7C, 0x32, 0x23, 0xFE, 0x2C, 0xC2, 0x00, 0x22, 0x62, 0x22, 0x2A, 0xC2, 0x46,
  0x04, 0x42, 0x22, 0x2A, 0xC2, 0x42, 0x18, 0x42, 0x26, 0x33, 0xE2, 0x7E, 0x10, 0xC0, 0x04, 0x23,
  0x22, 0x40,
};

#define QR_TEXT_IMAGE_AVAILABLE 1

#endif
