cobetckoe/HeartbeatSensor/(commit log)

2026-10-10 chore: 建立稳定基线 (v6 可运行版本)
    已实测通过的功能状态:
    - ESP32-C3 SuperMini + ST7735 160x128 (rot 1) 硬件 SPI @20MHz
    - HLK-LD2450 雷达 UART1 (GPIO4 RX / GPIO5 TX) @256000, 自动探测并锁定 NVS
    - 开机 LOGO 后直接进入雷达界面, 无任何中间检测页
    - 亮金 #FFD800 + 正红 #E60012 配色, 纯黑底最高对比
    - 全帧单窗口推送 pushCanvas(), 无花屏, 约 44 fps
    验证记录:
    - pio run: RAM 4.6% (15236 B) / Flash 26.8% (350926 B) / SUCCESS
    - esptool COM30 @460800: 4 段写入全部 Hash 校验通过
2026-10-10 chore: 按通用工程习惯整理项目结构
    在不改变固件行为的前提下，把仓库整理成「一个可维护工程 + 一份历史归档」的形态。
    清理后重新编译验证通过：RAM 4.6% (15236 B) / Flash 26.8% (350926 B)，与整理前一致。
    移除（内容已在 docs/legacy-snapshots/ 与 Git 历史中保留）
    - src/、include/：v9 双板（S3+C3）合并方案，已被 arduino/ESP32_C3_Radar_Tracker 取代
    - circuitpython/：早期 CircuitPython 原型，与当前 Arduino 固件无关
    - arduino/ESP32_Radar_Tracker/：ESP32-S3 分支，硬件已不再使用
    - 根 platformio.ini：旧的多 env 配置，指向已删除的 esp32s3
    - .vscode/launch.json：调试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
2026-10-22 feat: 画面流畅与 315MHz 收帧共存 (v7.2-display) + 工程结构整理
    一、推屏系统重做（核心修复）
    根因不是「推屏太久」，而是「单次连续 SPI 太久会被 RMT 录成一个假段」：
    帧长 163ms / 225 边沿，整屏推 21ms 阻塞会让接收机致盲，录出 ~10ms 平段，
    被判为一个超长段 → 整帧作废。决定成败的是单次连续 SPI 时长。
    三条规则：
    - SPI 固定 20MHz（40MHz 会把瞬态耦合进 315MHz DATA，crc>0）
    - 脏矩形 3000px 预算（≈6KB ≈2.4ms）；超预算本帧不推且不更新 _prev，
    差异累积到下一帧；有限预算模式下禁止整屏推
    - 门控 = !inFrame() && runSegs()==0 && push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
    [DebugLog.h, HLK_LD2450.h, LogoImage.h, OokReceiver.h, RadarDisplay.h, ZoneManager.h, app.c]
2026-10-22 fix: 光环卡死回退修复 + P3.3 检测脚失效安全加固 (v7.2.1-hotfix)
    ## 修复 1: 光环推到 1/3 处卡�? 随后整屏永久冻结
    pushDirty() 的推屏预算记错了量纲, 并叠加了一个死�?
    预算累加的是「逐行跨度之和」而不是实际脏像素:
    dirtyPx += (uint32_t)(hi - lo + 1);
    一条半�?r 的细圆弧跨很多行, 跨度之和约等�?pi*r^2. 代入预算 3000
    �?r ~= 31, 而雷达满量程半径�?96 -- 恰好在三分之一处越�? 这就�?
    肉眼看到的「推到一半�?
    越界后直�?return 且不更新 _prev, 本意是「差异累�? 等预算放开一次�?
    推出�? �?setPushBudget(3000UL) 每帧都在调用, 预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
    [RadarDisplay.h, app.c]
2026-10-28 feat: 涂鸦云接入 (TuyaLink MQTT) + 二维码配网
    新增 TuyaLink 云模块（离线优先，WiFi 开机默认关闭，长按 BOOT 2s 开启）：
    - ST_OFF/ST_SCAN/ST_WIFI/ST_TIME/ST_MQTT/ST_ONLINE + ST_AP 状态机，
    跑在独立 FreeRTOS 任务（栈 16384，prio 1）
    - HMAC-SHA256 鉴权，TLS 8883 连 m1.tuyacn.com，仅上报 11 个 DP
    - 三元组改为运行期 NVS 变量，配网页可填，不必重新编译
    - 雷达上报带死区（0.3m/5deg）+ 2s 节流
    AP 热点配网 + 屏幕二维码：
    - 无凭据或找不到路由时开热点 Kanchuan-HB-XXXX，captive portal
    - AP 模式屏幕显示 WiFi 二维码（微信/相机直扫免输密码）
    - 说明文字改为离线预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
2026-10-29 docs: 精简全部文档，去除过程叙述与注意事项
    - 重写 docs/TUYA-DP-SETUP.md，修复 GBK 转码造成的乱码
    - README 精简显示实现要点、常见问题、涂鸦章节
    - PROTOCOL-315M 精简编码原理与陷阱叙述
    - CHANGELOG v7.3 章节改为变更条目
    - legacy-snapshots README 精简
2026-10-29 feat: 雷达角度刻度 + DP 倍数修正(0) + 距离改厘米 + 无线方案统一 433 MHz
    - DP 倍数改 0（平台 scale 语义是小数位数，填 1 会让 APP 数值小 10 倍）
    - radar_distance 单位 0.1m -> cm，固件发整数厘米；DIST_EPS 3->30（等价 0.3m）
    - RadarDisplay: 网格标注 -60/-30/30/60 度（度符号 drawCircle 手画，GFX 无该字形）
    - 删除左上角数值读数与 0 度标注；量程圈补 2m/4m/6m（6m 原坐标越界）
    - 命名统一 315->433: ook433.h/.c、PROTOCOL-433M.md、PIN_TX433、__OOK433_H__
    - 天线 λ/4 23.8cm -> 17.3cm；协议与载波无关，解码逻辑零改动
    - 从机 GBK 文件按 GBK 读写，中文零损；slave.uvproj 保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
    [DebugLog.h, OokReceiver.h, RadarDisplay.h, TuyaConfig.h, TuyaLink.h, ZoneManager.h, app.c]
2026-10-29 chore: 清理死代码与重复文件，整合文档
    删除（全部零调用点，对外行为/日志格式/433 协议/DP 语义未变）：
    - OokReceiver.h 整套「让路窗」机制：OOK_BURST_HOLD_US / OOK_BUSY_SEGS /
    OOK_FRAME_MAX_US 三宏、preRun()、_quietUntil / _frameUntil / _preRunPrev
    及其全部读写点。两个读取方 busy() / quietLeftMs() 早已零调用，而主循环
    门控 rxBusy = inFrame() || runSegs() > 0 本身就严格强于旧的启发式。
    - OokReceiver.h 另 7 个零引用宏：OOK_FLAG_TAMPER / OOK_FLAG_LOWBAT /
    OOK_FLAG_STATE_MASK / OOK_FRAME_SEGMENTS / OOK_GLITCH_US /
    OOK_SUM_MIN / OOK_SUM_MAX。
    - RadarDisplay.h 10 个孤儿颜色常量（ECG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
2026-10-29 feat: 从机单击切换检测（松手即生效）+ P3.2 串联指示灯，P5.4 回归纯继电器
    - 单击语义统一：开和关都是单击，且【松手那一刻立即动作】。
    之前为了等双击判定把动作延后 0.4 s —— 开检测等一下是撤离时间，
    但关检测绝不该等，那个延时没有任何意义。
    - 400 ms 窗口保留，但只做一件事：识别「还有没有第二下」。
    窗口到点只清 s_clicks，不再 toggle，否则就变成「松手开 -> 0.4 s 后又关」。
    - 双击 = 配对，且只有双击是配对。双击的第一下会顺带切换一次检测，
    用 App_EnterPairing() 强制清 s_armed/s_present/盲窗/去抖并置 s_s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
2026-10-29 feat: 从机按键按状态分离（待机才分单双击）+ 配对 20 s 超时/单击提前退出
    上一版（54ccaa4）为了消除「关检测要等 0.4 s」的坏手感，让三个状态都
    「松手即刻切换」，副作用是待机态无法再区分「单击开检测」与「双击进配对的
    第一下」，语义始终含混。本版按状态拆开：
    | 状态 | 单击 | 双击 |
    |------|------------------------------|------------------|
    | 待机 | 开检测（等 400 ms 窗口确认） | 进配对（20 s） |
    | 检测 | 关检测（松手立即生效） | 不识别 |
    | 配对 | 退出配对回待机（立即）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
2026-11-03 fix(slave): 修复布防态被干扰误关检测；诊断 433 发射模组烧毁
    从机按键语义改为「松手那一拍生效」，配对改用长按 1.5 s（与主机
    BTN_LONG_PAIR_MS 对齐），废弃双击与 400 ms 等待窗口。
    修复「开了之后很快自己又关了」：
    布防态能被清零的唯一路径是 App_OnRelease 的 armed 分支，而它可被
    纯下降沿触发（App_PollButton 的 else if (edge != 0u)，hold==0 时
    旧代码无条件放行，仅 30 ms 的 s_btn_lock 守卫）。该分支只可能在轮询
    全程没采到过低电平时到达，捕获的正是「只有下降沿、没有低电平」=
    EMI 毛刺。开检测这一刻干扰最强：3 帧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
    [app.c]
2026-11-03 release: 1.0.0 首次发布
    项目结构整理
    - 从机目录规范命名：src/slave/Sources -> src/slave/source，inc -> include
    - slave.uvproj 工程路径同步更新（保持无 BOM）
    - 删除历史存档 docs/legacy-snapshots/（10 个文件）
    - 删除无用的从机编译产物与备份文件
    文档合并
    - SERIAL-LOG.md + TROUBLESHOOTING.md 合并为 docs/DIAGNOSTICS.md
    - LOGO.md 并入 docs/DISPLAY.md
    - docs/README.md 与 utils/README.md 的索引内容并入根 README.md
    - docs/ 精简为 4 份：DIAGNOSTICS / DISPLAY / PROTOCOL-433M / TUYA-DP-SETUP
    - 重写 README.md：补齐硬件表、接线表、工程结构树、从机固件、工具脚本、按键语义
    - 重写 PROTOCOL-4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
2026-11-04 feat: 1.1.0 迁移 ESP32-C3-MINI-1-N4 + 电池电量监测 + 涂鸦 DP 收敛为 7 个
    硬件平台
    - 主控由 C3 SuperMini 换成 C3-MINI-1-N4（4MB flash，22 GPIO）
    - 引脚重排：TFT CS=10/DC=1/BLK=3，振动=GPIO21，电池 ADC=GPIO0
    - 屏 RST 改接模组 EN（驱动传 TFT_RST=-1，走 ST77XX_SWRESET）
    - ★ strapping 策略：C3 只有 GPIO2/GPIO8/GPIO9 三个 strapping 脚
    - GPIO2/GPIO8 完全不用、悬空（输出绝不允许落在 strapping 脚）
    - GPIO9 只作 BOOT 按键输入 + 内部上拉（strapping 语义与按键天然一致）
    新增电池监测
    - BatteryMonitor.h：GPIO0/ADC1_CH0，12dB 衰减，analogReadMilliVolts()
    - 1MΩ/1MΩ 分压，13 点放电曲线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
2026-11-04 docs: 统一主控命名为 N4 模组，合并接线说明并补充新旧接线对照
    - 版本号回退为 1.0.0（C3 迁移 + 电池监测归入本次首发）
    - README 接线章节合并为「主控接线总表 / 电池检测 / 从机接线」三块
    - 新增「与上一版 SuperMini 相比接线改了哪些」对照表：只动 4 处 + 新增 1 处
    - 新增接线自检速查表；诊断手册补电池/电量异常条目
    - 主控称谓统一为「N4 模组」，去掉 C3 与 N4 两套写法
2026-11-04 docs: 删除旧开发板迁移记录，补充白屏排查项
2026-11-04 docs: 修正可用 GPIO 计数，精简冗余说明
2026-11-05 feat: 开源协议由 MIT 改为 GPL-3.0-or-later
    - LICENSE 换成 GNU GPL v3 官方全文，保留第三方组件声明
    （Adafruit MIT/BSD、海凌科 HLK-LD2450、Keil C51 工具链）
    - 全部源码加 SPDX-License-Identifier: GPL-3.0-or-later 与版权行
    （主控 11 个 + 从机 7 个）
    - 生成脚本 utils/logo_converter.py / utils/make_qr_text.py 同步加 SPDX 头，
    重新生成结果与手改一致
    - README 项目树与「许可」章节同步更新
    - CHANGELOG 新增 [未发布] 许可条目
2026-11-06 feat: 开源协议按 GitHub 标准改为 GPL-3.0
    - LICENSE 只保留 GNU GPL v3 官方全文，逐字节与 gnu.org 一致
    （SHA256 3972DC97...D6AF86C9DFB36986），GitHub 可自动识别为 GPL-3.0
    - 新增 NOTICE：版权抬头、第三方组件声明（Adafruit MIT/BSD、
    海凌科 HLK-LD2450、Keil C51 工具链）、致谢、联系方式
    - 许可版本锁定 version 3，不采用 or-later
    - 全部源码 SPDX 改为 GPL-3.0-only（主控 11 + 从机 7 个文件）
    - 生成脚本同步，重跑输出与手改一致
    - README 加 GPL v3 badge，末章改为「开源协议」
    - CHANGELOG 更新许可条目
2026-11-06 docs: 致谢补充 eric-rolph/esp32-radar-tracker 参考项目
    - README「致谢」与 NOTICE「Acknowledgments」同步加入该 MIT 参考项目
    - NOTICE「Third-Party Components」增加其 MIT 许可全文与版权声明
    - src/master/HLK_LD2450.h 头部补派生来源归属（保留原 MIT 版权声明）
    - CHANGELOG「未发布」新增致谢小节记录上述改动
2026-11-06 docs: 开源协议回退 MIT，项目名保持 HeartbeatSensor
    - LICENSE 改回 MIT 官方全文，NOTICE 重写为 MIT 归属结构
    （项目抬头 → 派生作品 → 第三方组件 → 致谢 → 联系方式）
    - 全部源码 SPDX 标识由 GPL-3.0-only 改回 MIT
    （主控 11 个 + 从机 7 个 + 2 个自动生成头文件 + 2 个生成脚本）
    - 保留 eric-rolph/esp32-radar-tracker (MIT) 的归属声明与致谢
    - README badge 改 MIT，开源协议章节同步
    - 新增 docs/HARDWARE.md，硬件另行在立创开源硬件平台（OSHW）开源
    - 项目名保持 HeartbeatSensor 不变
    从机 0 Error(s) 0 Warning(s)，主机构建通过。
    [BatteryMonitor.h, DebugLog.h, HLK_LD2450.h, LogoImage.h, OokReceiver.h, QrTextImage.h, RadarDisplay.h, TuyaConfig.h]
2026-11-06 chore: 清理仓库无用文件，涂鸦三元组改为占位符
    - 移除 11 个可再生 LOGO / 预览图（由 make_logo.py、logo_converter.py、
    make_qr_text.py 生成），并加入 .gitignore；固件用的点阵
    src/master/LogoImage.h / QrTextImage.h 仍随仓库入库
    - 第三方字体 ChongXiSmallSeal.otf 不入库（21.8 MB，见 utils/fonts/README.md）
    - src/master/TuyaConfig.h 的涂鸦 ProductID / DeviceID / DeviceSecret
    改为 YOUR_* 占位符，改用 AP 配网页写入 NVS（NVS 优先）
    - README 工程结构树同步
2026-11-09 docs: 中文名统一为心跳传感器，新增弹匣充电座设计，精简 README
    - 中文名统一为「心跳传感器」（README / HARDWARE / master.ino / build.ps1 / flash.ps1）
    英文仓库名与目录名保持 HeartbeatSensor 不变
    - HARDWARE.md 新增 §6「从机供电与弹匣充电座」：
    · 从机自身不带充电电路（SOP8 占满 / 无 USB 可插 / 避免待机功耗）
    · 从机侧：锂电 3.7 V + PTC 0.75 A + 升压 5 V，只引出 2 片磁吸触点
    · 充电座即弹匣本体，一拖四：TP4056 x4、USB-C 5V/2A、每路 500 mA
    · 磁极防呆：座内左 S 右 N，反装吸不住
    · 原 §6~§10 顺延为 §7~§11，BOM 由 18 项扩到 25 项
    - REA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
2026-11-09 docs: 改名心跳探测器，硬件设计详细移交立创开源
    - 中文名由「心跳传感器」更正为「心跳探测器」
    涉及 README / docs/HARDWARE.md 标题、master.ino 文件头、
    build.ps1 / flash.ps1 说明；英文仓库名 HeartbeatSensor 不变
    - 硬件设计（原理图 / PCB / 3D / BOM）改在立创开源硬件平台发布，
    本仓库不含任何硬件工程文件
    - docs/HARDWARE.md 精简为「只提及」：15245 -> 5862 字节，11 章 -> 8 章
    · 移除完整 BOM 表、主机接线总表、引脚占用总表、电池分压图、
    从机接线表、充电座详细设计（拓扑/电流/磁极尺寸）、装配自检速查
    · 保留固件强耦合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
